NerdFlare/NerdFlareBadge26/code/requirements-circuitpython.txt

neopixel
adafruit_led_animation
asyncio
adafruit_ticks
