NerdFlare/NerdFlareBadge26/pcb/NerdFlareBadge26.kicad_pcb

## KiCad design pcb/NerdFlareBadge26.kicad_pcb (2026-03-31)

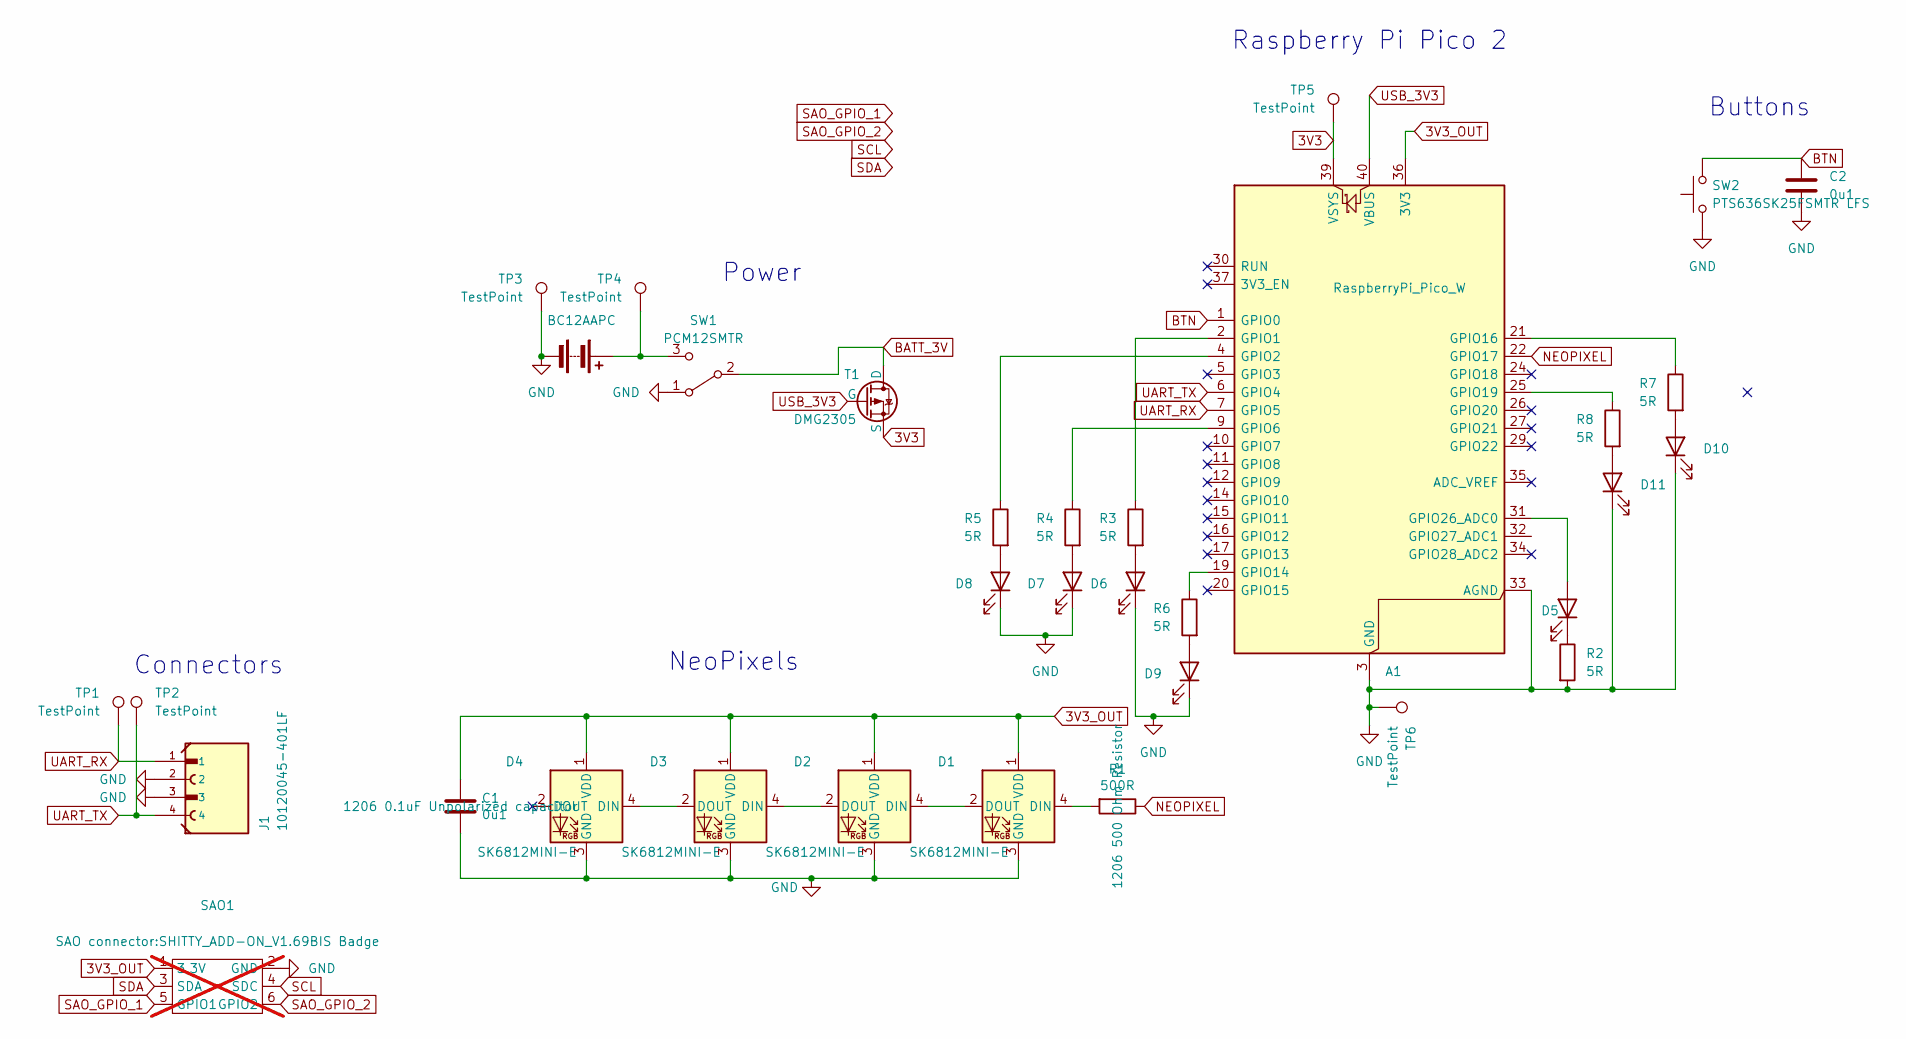
[picture p1: schematic NerdFlareBadge26.kicad_sch]

Parts:
A1: RaspberryPi_Pico_W; RPi_Pico_SMD
BT1: BC12AAPC; BAT_BC12AAPC
C1, C2: 0u1; C_1206_3216Metric_Pad1.33x1.80mm_HandSolder
D1, D2, D3, D4: SK6812MINI-E
D5, D6, D7, D8, D9, D10, D11: B1501TW--20P001013U1930; LED_1206_3216Metric_Pad1.42x1.75mm_HandSolder
J1: 10120045-401LF; AMPHENOL_10120045-401LF; PARTREV A
R1: 500R; R_1206_3216Metric_Pad1.30x1.75mm_HandSolder
R2, R3, R4, R5, R6, R7, R8: 5R; R_1206_3216Metric_Pad1.30x1.75mm_HandSolder
SAO1: SHITTY_ADD-ON_V1.69BIS Badge; not fitted
SW1: PCM12SMTR; SW_SPDT_PCM12
SW2: PTS636SK25FSMTR LFS; SMT Tactile Switch CK PTS636SK25FSMTR
T1: DMG2305; SOT-23
TP1, TP2, TP3, TP4, TP5, TP6: TestPoint; TestPoint_Pad_1.5x1.5mm

Connections:
3V3: A1.39 (VSYS), T1.2 (S), TP5.1
3V3_OUT: A1.36 (3V3), C1.1, D1.1 (VDD), D2.1 (VDD), D3.1 (VDD), D4.1 (VDD), SAO1.1 (3.3V)
BATT_3V: SW1.2 (B), T1.3 (D)
BTN: A1.1 (GPIO0), C2.1, SW2.2
GND: A1.3 (GND), A1.8 (GND), A1.13 (GND), A1.18 (GND), A1.23 (GND), A1.28 (GND), A1.33 (AGND), A1.38 (GND), BT1.2 (-), C1.2, C2.2, D1.3 (GND), D2.3 (GND), D3.3 (GND), D4.3 (GND), D6.1 (K), D7.1 (K), D8.1 (K), D9.1 (K), D10.1 (K), D11.1 (K), J1.2, J1.3, R2.2, SAO1.2 (GND), SW1.1 (A), SW2.1, TP3.1, TP6.1
NEOPIXEL: A1.22 (GPIO17), R1.1
unnamed: A1.2 (GPIO1), R3.1
unnamed: A1.4 (GPIO2), R5.1
unnamed: A1.9 (GPIO6), R4.1
unnamed: A1.19 (GPIO14), R6.1
unnamed: A1.21 (GPIO16), R7.1
unnamed: A1.25 (GPIO19), R8.1
unnamed: A1.31 (GPIO26_ADC0), D5.2 (A)
unnamed: BT1.1 (+), SW1.3 (C), TP4.1
unnamed: D1.4 (DIN), R1.2
unnamed: D1.2 (DOUT), D2.4 (DIN)
unnamed: D2.2 (DOUT), D3.4 (DIN)
unnamed: D3.2 (DOUT), D4.4 (DIN)
unnamed: D5.1 (K), R2.1
unnamed: D6.2 (A), R3.2
unnamed: D7.2 (A), R4.2
unnamed: D8.2 (A), R5.2
unnamed: D9.2 (A), R6.2
unnamed: D10.2 (A), R7.2
unnamed: D11.2 (A), R8.2
SAO_GPIO_1: SAO1.5 (GPIO1)
SAO_GPIO_2: SAO1.6 (GPIO2)
SCL: SAO1.4 (SDC)
SDA: SAO1.3 (SDA)
UART_RX: A1.7 (GPIO5), J1.1, TP1.1
UART_TX: A1.6 (GPIO4), J1.4, TP2.1
USB_3V3: A1.40 (VBUS), T1.1 (G)

Notes on the sheet:
Buttons
Power
NeoPixels
Connectors
Raspberry Pi Pico 2

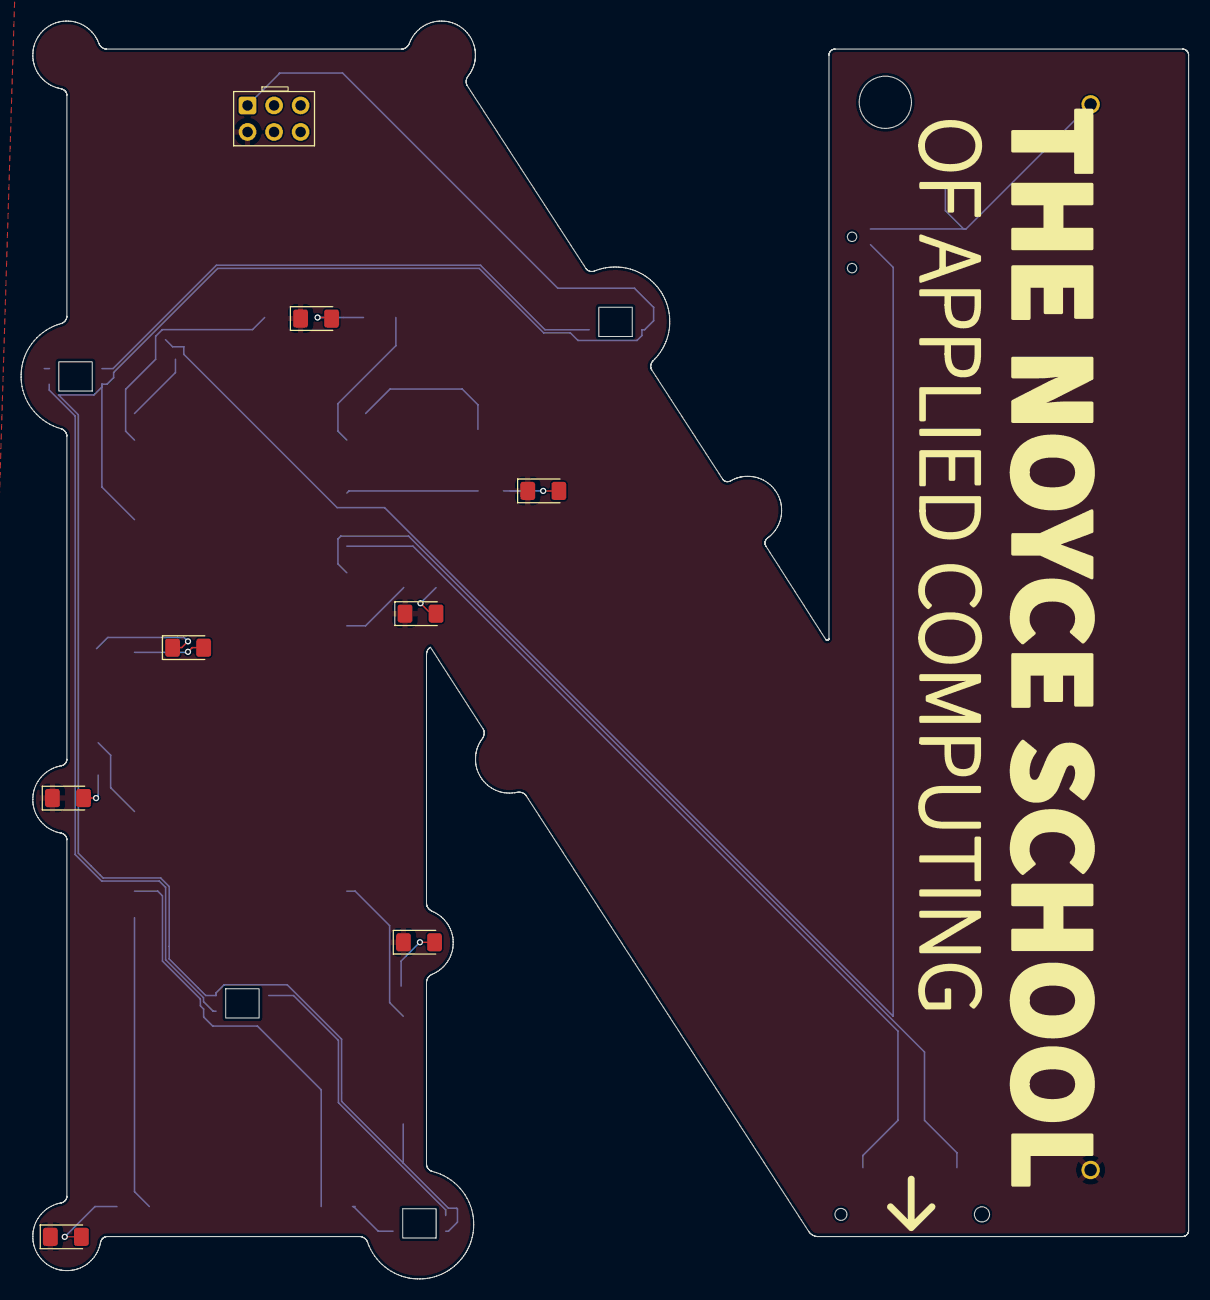
[picture p2: board NerdFlareBadge26.kicad_pcb from above]

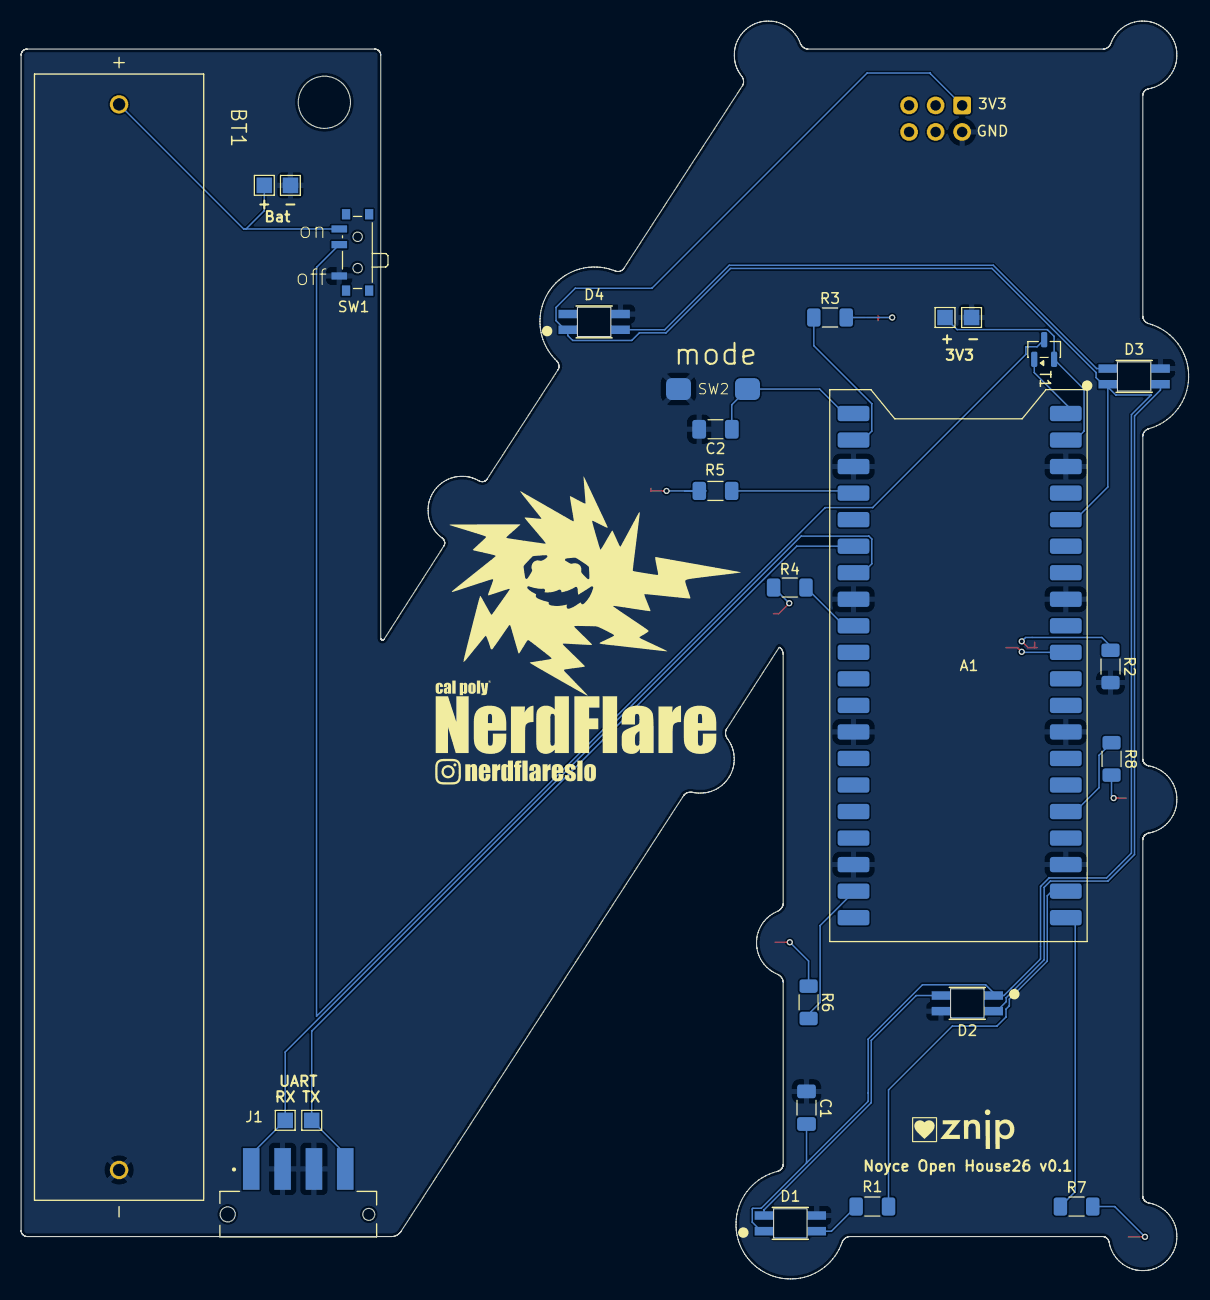
[picture p3: board NerdFlareBadge26.kicad_pcb from below]

Board: 2 copper layers, 111.7 x 120.4 mm, 34 parts (22 on the bottom side), 28 nets.
