NerdFlare/NerdFlareBadge26/(commit log)

2026-03-31 Initial commit of v0.1 and sample code.
    [NerdFlareBadge26.kicad_pcb, NerdFlareBadge26.kicad_sch]
2026-04-03 v0 of firmware supporting game and sparkle mode. adding examples.py with a few unused LED animations, settings.json which keeps game and mode settings stateful, and requirements for necessary circuit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
2026-04-08 v0.1 of firmware. Updated GPIO ports to match v0.1 hardware, updated the anaimation logic a little bit, and tried to fix a race condition with changing the CURRENT_LEVEL in the uart task while acting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
    [code.py]
2026-04-09 v0,1,1: Cleaned up the animation a bit when switching from game to sparkle mode; fixed a bug where the button was being checked before being fully pulled up; added LED brightness as a system setting;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
    [code.py]
